JRSHENK/Door-Operator/README.md

# Door-Operator
Esp32 Based overhead door operator controller for 2 doors.
