JRSHENK/Door-Operator/DoorOperator.kicad_pcb

## KiCad design DoorOperator.kicad_pcb (2022-04-08)

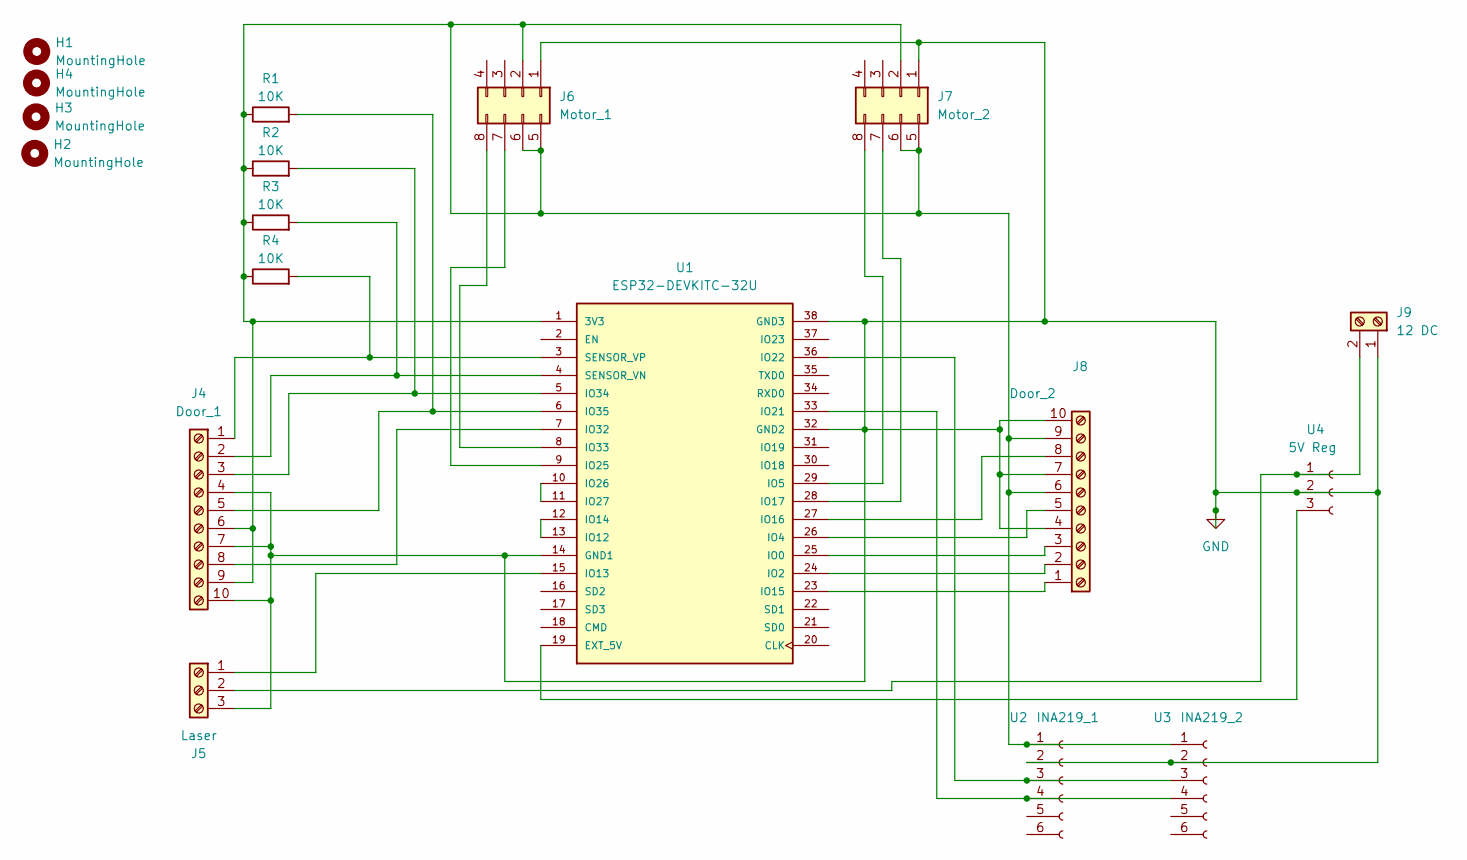
[picture p1: schematic DoorOperator.kicad_sch, Dual Door Operator]

Parts:
H1, H2, H3, H4: MountingHole; MountingHole_3.2mm_M3_Pad_TopBottom
J4: Door_1; TerminalBlock_Phoenix_MKDS-1,5-10_1x10_P5.00mm_Horizontal
J5: Laser; TerminalBlock_Phoenix_MKDS-1,5-3-5.08_1x03_P5.08mm_Horizont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
J6: Motor_1; PinHeader_2x04_P2.54mm_Vertical
J7: Motor_2; PinHeader_2x04_P2.54mm_Vertical
J8: Door_2; TerminalBlock_Phoenix_MKDS-1,5-10_1x10_P5.00mm_Horizontal
J9: 12 DC; TerminalBlock_Phoenix_MKDS-1,5-2_1x02_P5.00mm_Horizontal
R1, R2, R3, R4: 10K; R_Axial_DIN0207_L6.3mm_D2.5mm_P7.62mm_Horizontal
U1: ESP32-DEVKITC-32U; MODULE_ESP32-DEVKITC-32U; PARTREV N/A
U2: INA219_1; INA219_Module
U3: INA219_2; INA219_Module
U4: 5V Reg; PinSocket_1x03_P2.54mm_Vertical

Connections:
GND: J4.4, J4.7, J4.10, J5.3, J6.1, J7.1, J8.4, J8.7, J8.10, J9.1, U1.14 (GND1), U1.32 (GND2), U1.38 (GND3), U2.2, U3.2, U4.2
unnamed: J4.1, R4.2, U1.3 (SENSOR_VP)
unnamed: J4.2, R3.2, U1.4 (SENSOR_VN)
unnamed: J4.3, R2.2, U1.5 (IO34)
unnamed: J4.5, R1.2, U1.6 (IO35)
unnamed: J4.6, J4.9, J6.2, J6.5, J6.6, J7.2, J7.5, J7.6, J8.6, J8.9, R1.1, R2.1, R3.1, R4.1, U1.1 (3V3), U2.1, U3.1
unnamed: J4.8, U1.7 (IO32)
unnamed: J5.1, U1.15 (IO13)
unnamed: J5.2, J9.2, U4.1
unnamed: J6.7, U1.9 (IO25)
unnamed: J6.8, U1.8 (IO33)
unnamed: J7.7, U1.28 (IO17)
unnamed: J7.8, U1.29 (IO5)
unnamed: J8.1, U1.23 (IO15)
unnamed: J8.2, U1.24 (IO2)
unnamed: J8.3, U1.25 (IO0)
unnamed: J8.5, U1.26 (IO4)
unnamed: J8.8, U1.27 (IO16)
unnamed: U1.10 (IO26), U1.11 (IO27)
unnamed: U1.12 (IO14), U1.13 (IO12)
unnamed: U1.19 (EXT_5V), U4.3
unnamed: U1.33 (IO21), U2.4, U3.4
unnamed: U1.36 (IO22), U2.3, U3.3

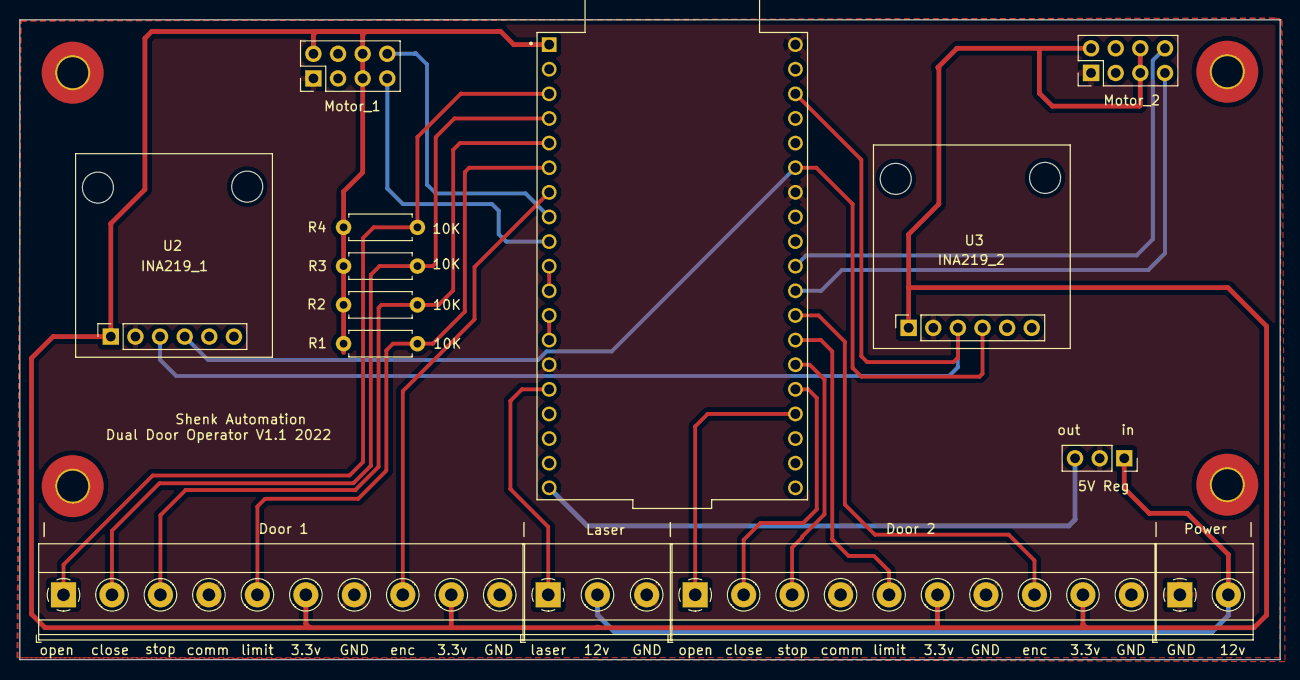
[picture p2: board DoorOperator.kicad_pcb from above]

Board: 2 copper layers, 130.0 x 66.0 mm, 18 parts (0 on the bottom side), 23 nets.
